redm3/228798-Individual-Research-Project-/README.md

# 228798-Individual-Research-Project-
Copper Wire Width Detection To Stepper Motor (TCP)
[16049816.pdf](https://github.com/redm3/228798-Individual-Research-Project-/files/10140026/16049816.pdf)
